ValerioCac/SE_Eyeglasses/README.md

# SE_Eyeglasses
Thesis about "Sensor-equipped Eyeglasses" for a bachelor degree in computer science.
