ValerioCac/SE_Eyeglasses/Images/AlgorithmFlowChart/AlgorithmFlowChart1.png

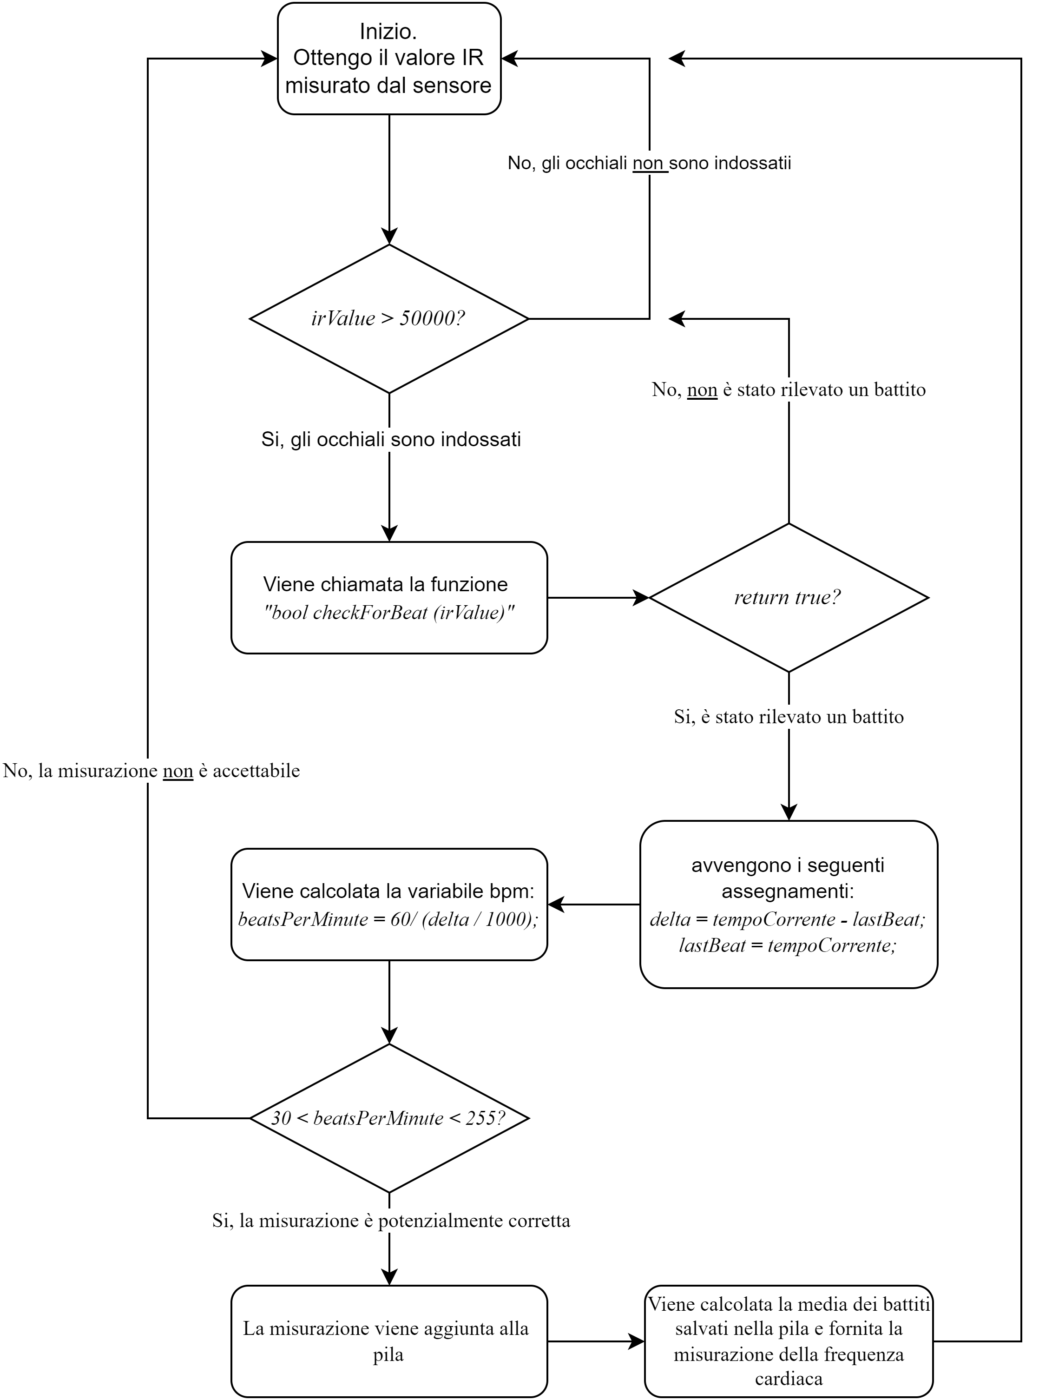
Images/AlgorithmFlowChart/AlgorithmFlowChart1.png
