ValerioCac/SE_Eyeglasses/Images/AlgorithmFlowChart/AlgorithmFlowChart2.png

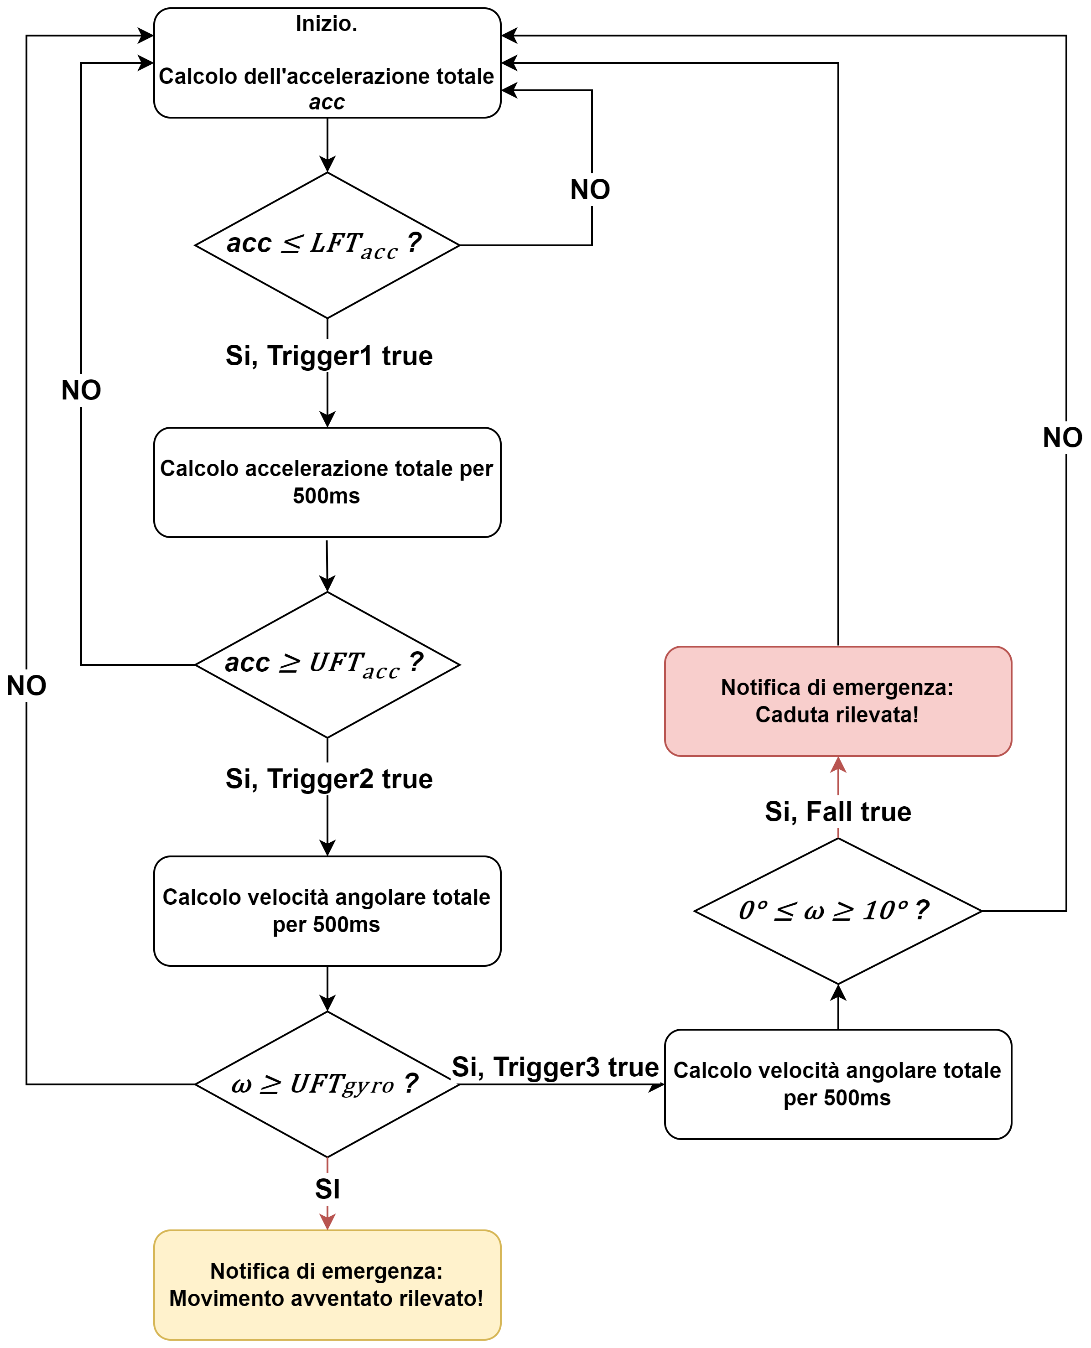
Images/AlgorithmFlowChart/AlgorithmFlowChart2.png
