ValerioCac/SE_Eyeglasses/Images/AlgorithmFlowChart/AlgorithmFlowChart3.png

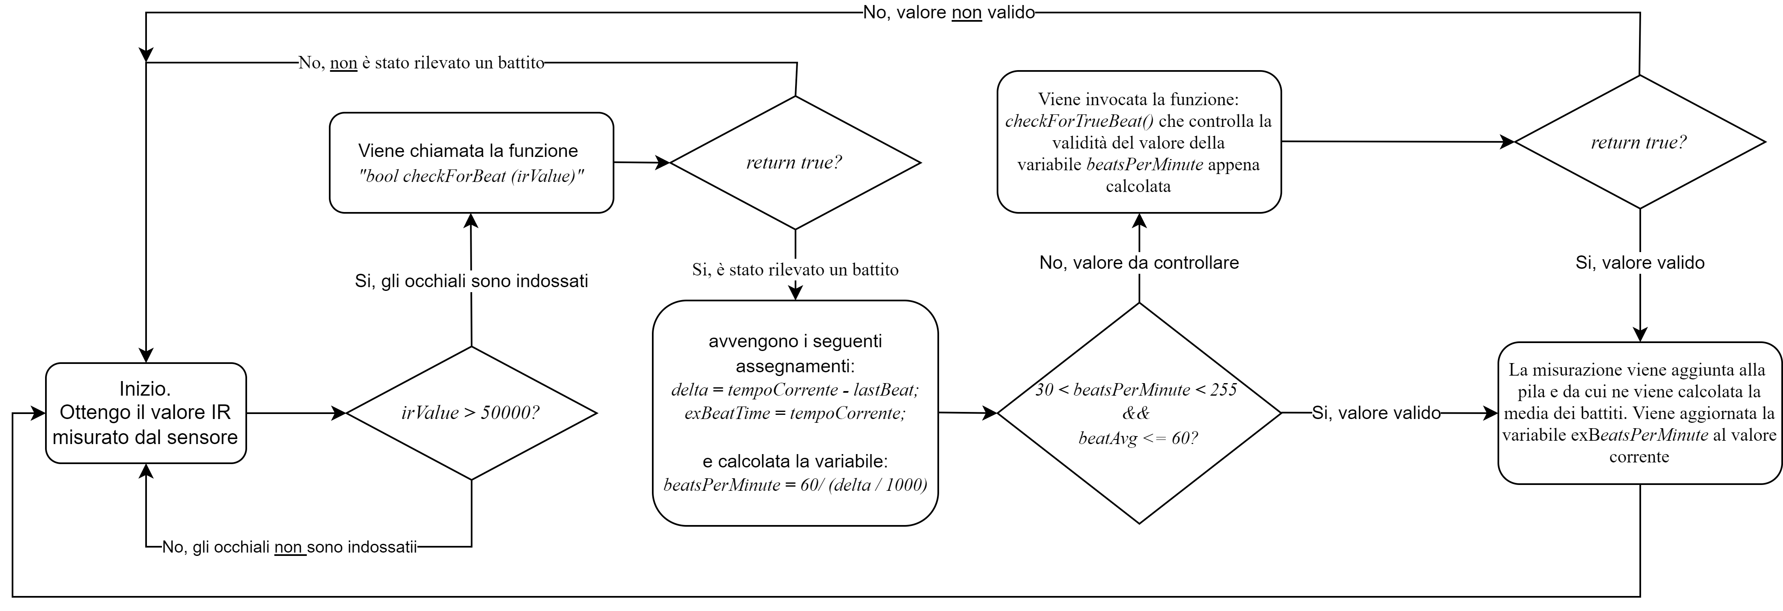
Images/AlgorithmFlowChart/AlgorithmFlowChart3.png
