ValerioCac/SE_Eyeglasses/Images/CircuitDesignDiagrams/CircuitDesign_img1.png

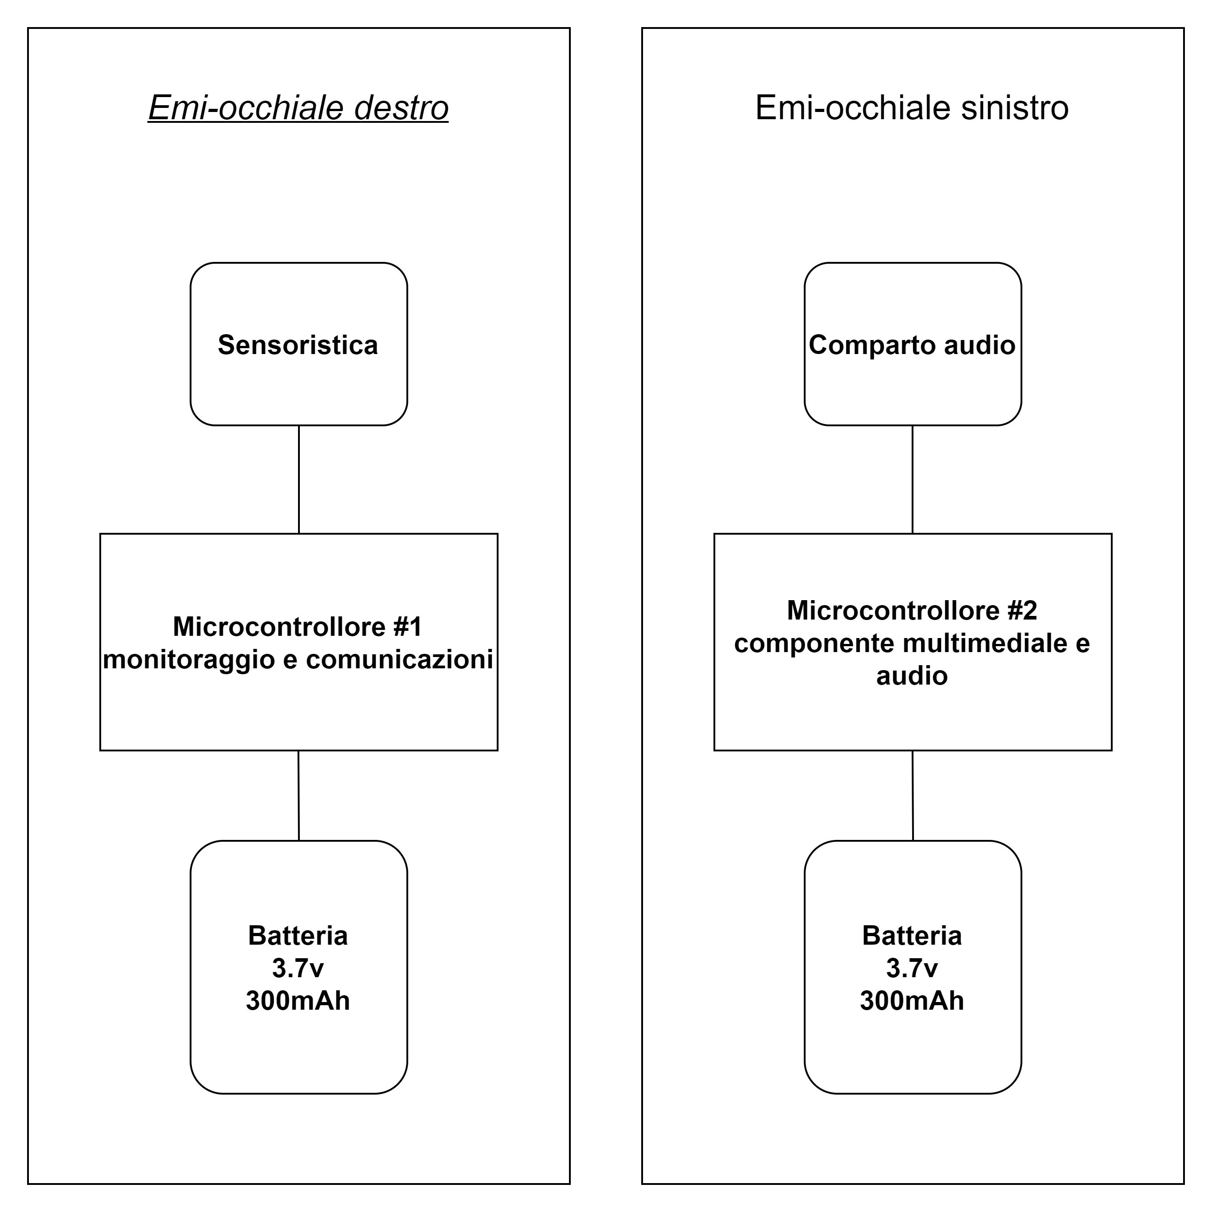
Images/CircuitDesignDiagrams/CircuitDesign_img1.png
