ValerioCac/SE_Eyeglasses/Images/CircuitDesignDiagrams/CircuitDesign_img2.png

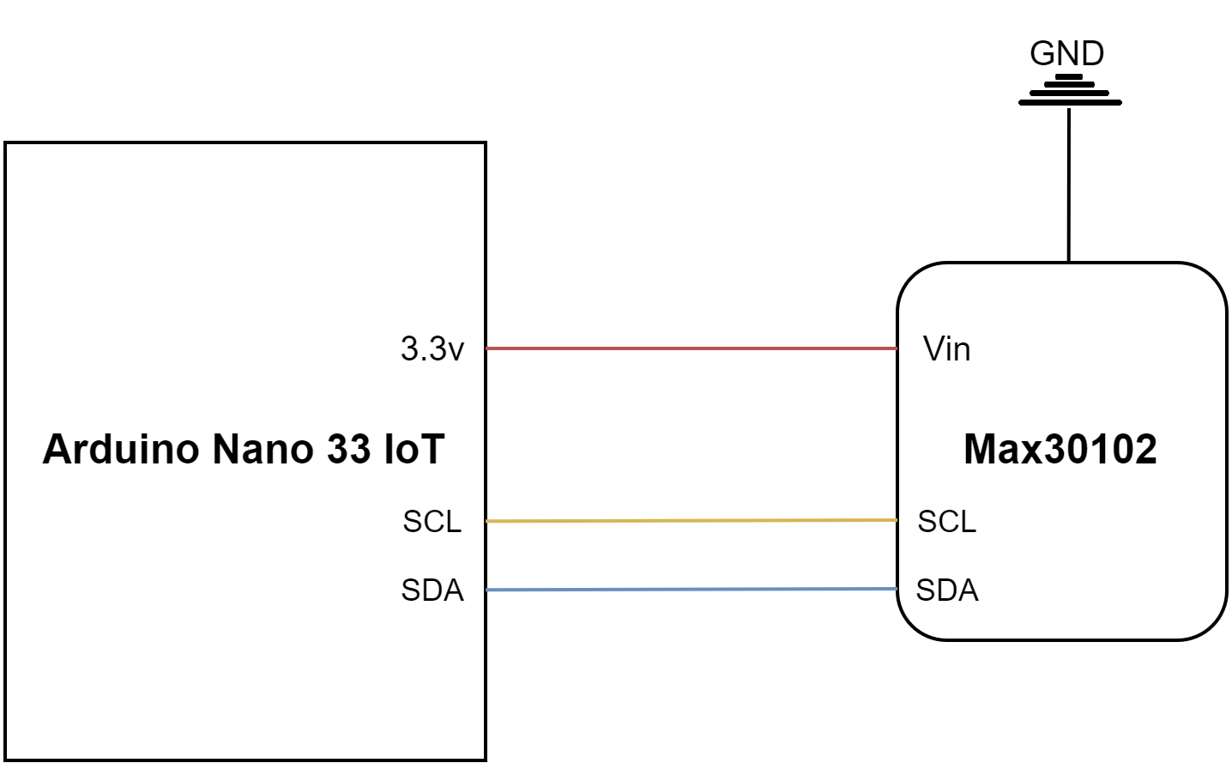
Images/CircuitDesignDiagrams/CircuitDesign_img2.png
