ValerioCac/SE_Eyeglasses/Images/CircuitDesignDiagrams/CircuitDesign_img3.png

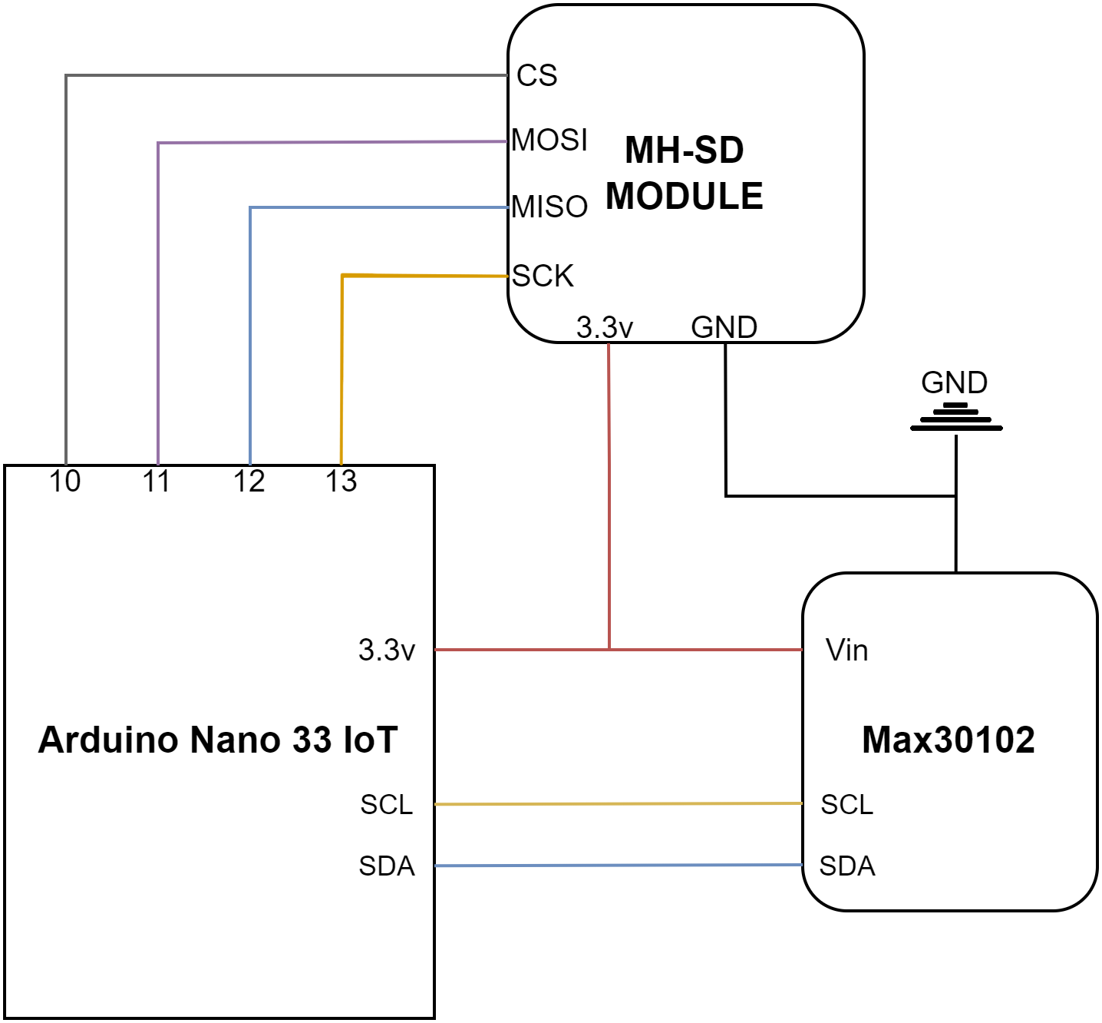
Images/CircuitDesignDiagrams/CircuitDesign_img3.png
