ValerioCac/SE_Eyeglasses/Images/Prototypes/3D Renderings/SE-Eyeglasses 2.0v v9.png

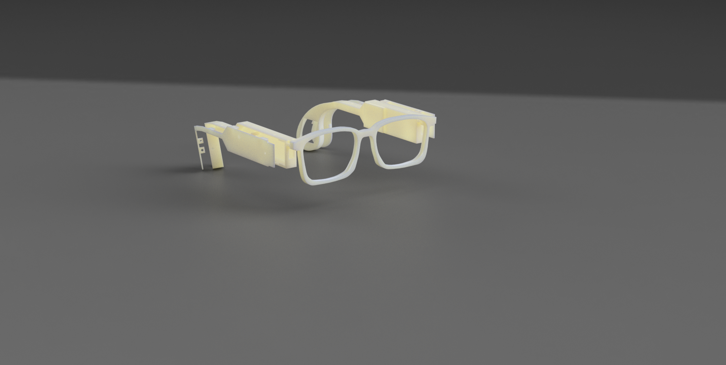
Images/Prototypes/3D Renderings/SE-Eyeglasses 2.0v v9.png
