ValerioCac/SE_Eyeglasses/Images/Prototypes/3D Renderings/SE-Eyeglasses 3.0v v51.png

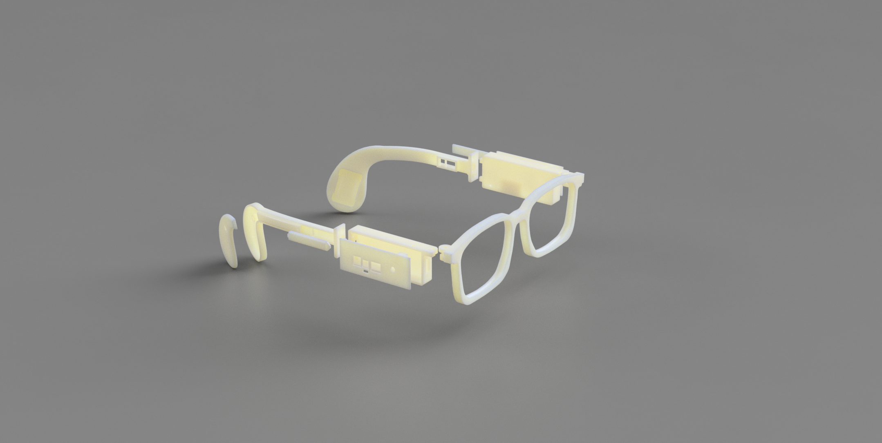
Images/Prototypes/3D Renderings/SE-Eyeglasses 3.0v v51.png
