ValerioCac/SE_Eyeglasses/Images/Prototypes/3D Renderings/SE-Eyeglasses Final v13.png

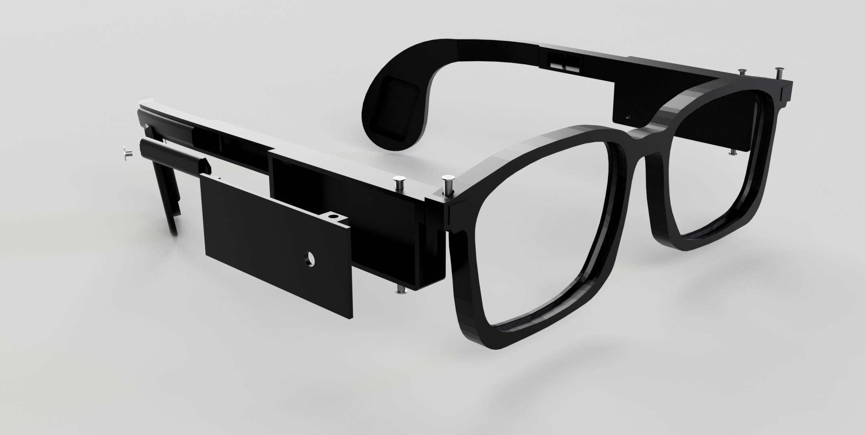
Images/Prototypes/3D Renderings/SE-Eyeglasses Final v13.png
