ValerioCac/SE_Eyeglasses/Images/Prototypes/Prototypes Sketch.png

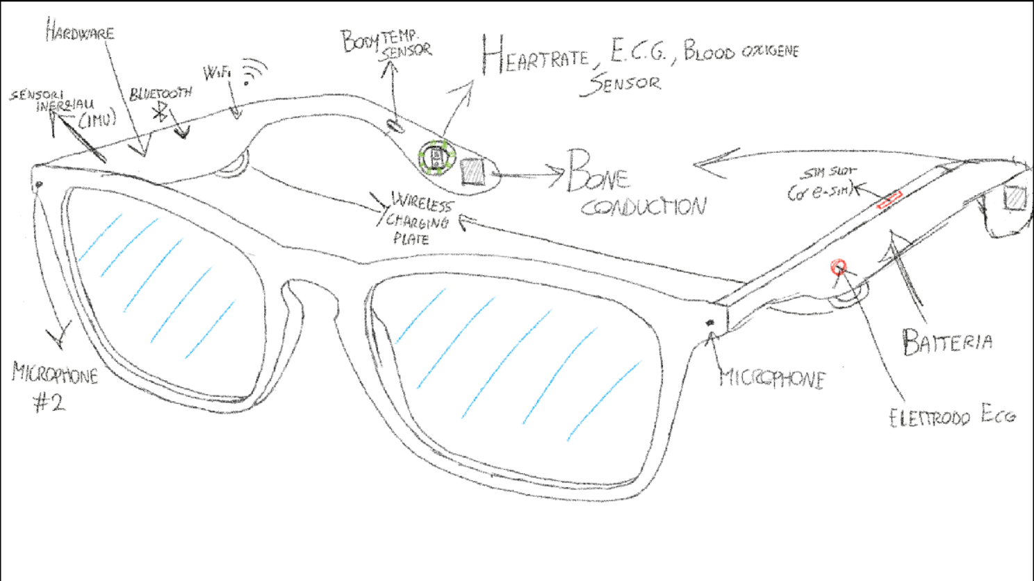
Images/Prototypes/Prototypes Sketch.png
