ValerioCac/SE_Eyeglasses/Images/Prototypes/Version 4/Asta_DX.png

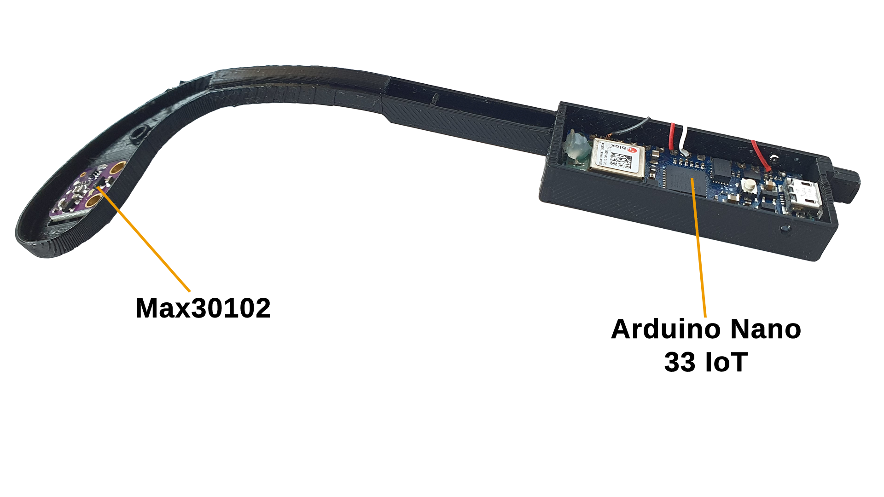
Images/Prototypes/Version 4/Asta_DX.png
