ValerioCac/SE_Eyeglasses/Images/Prototypes/Version 4/Asta_SX.png

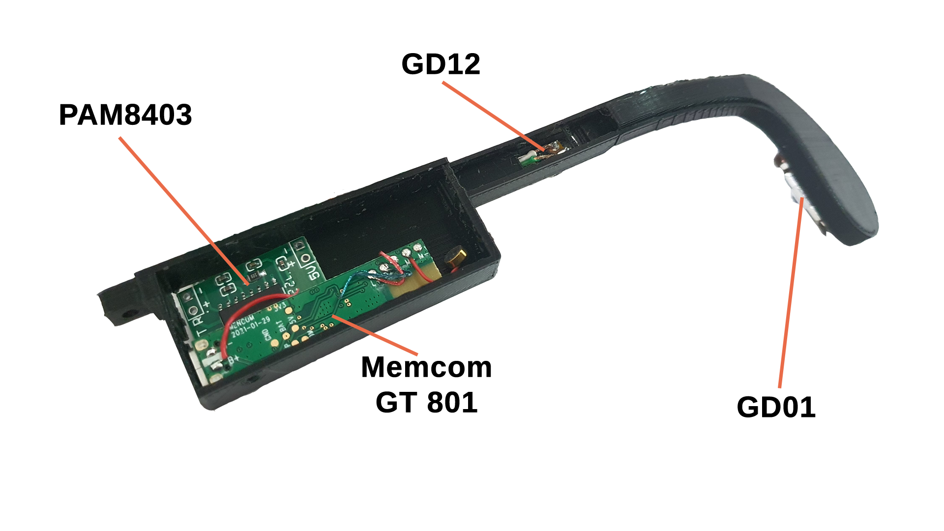
Images/Prototypes/Version 4/Asta_SX.png
