ValerioCac/SE_Eyeglasses/Images/Prototypes/Version 4/Se_Eyeglasses.png

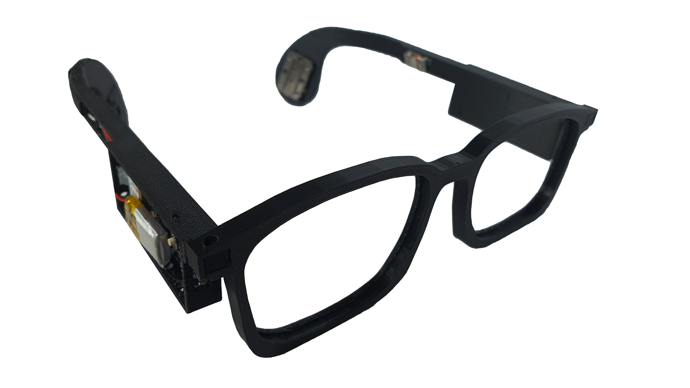
Images/Prototypes/Version 4/Se_Eyeglasses.png
