ValerioCac/SE_Eyeglasses/3D Models/Timelapse/STL/Frame.stl

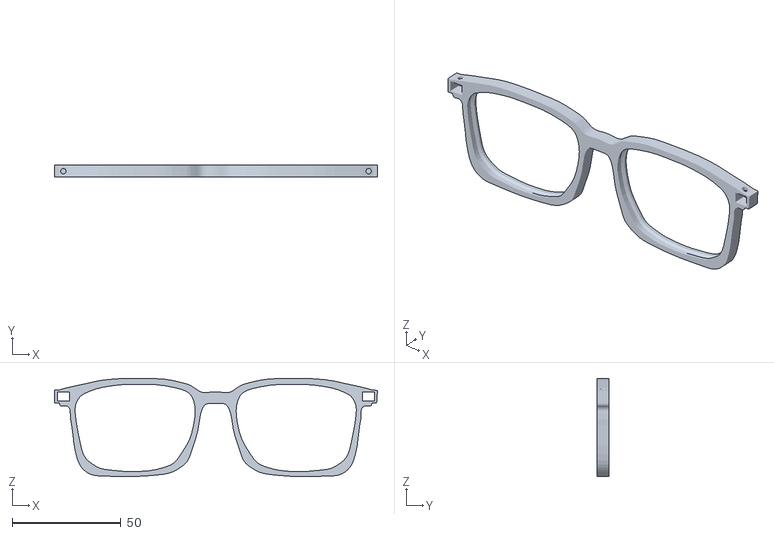
[picture p63: CAD file, 2022-03-22]
3D Models/Timelapse/STL/Frame.stl
148.6 x 5.45 x 45.2
