ValerioCac/SE_Eyeglasses/3D Models/Timelapse/STL/Asta DX.stl

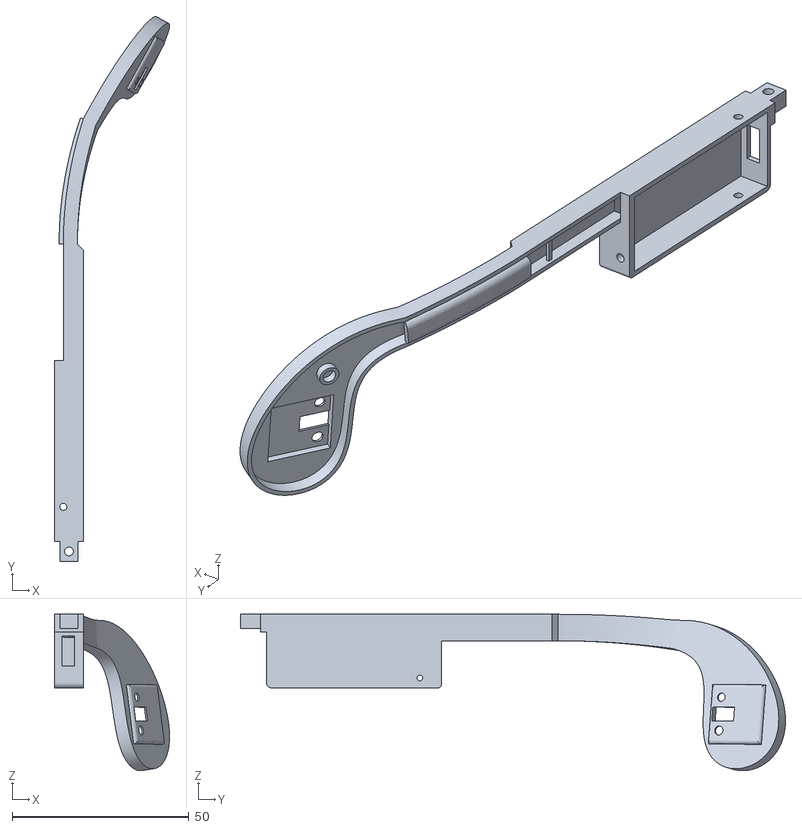
[picture p64: CAD file, 2022-03-22]
3D Models/Timelapse/STL/Asta DX.stl
32.5 x 154.0 x 44.2
