ValerioCac/SE_Eyeglasses/3D Models/Timelapse/STL/SX copCorpo.stl

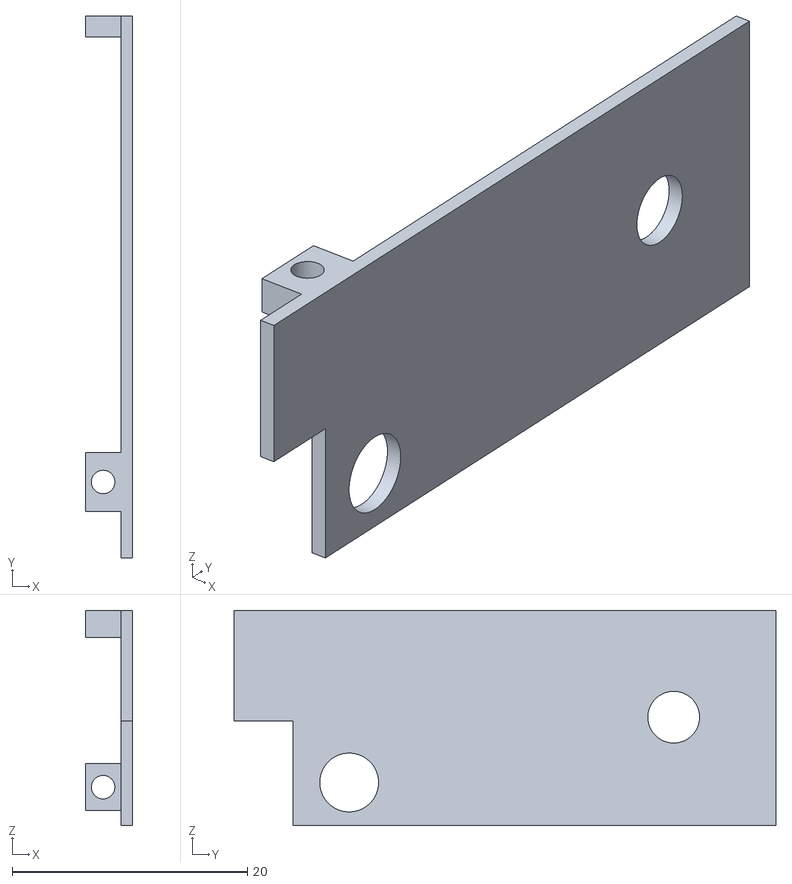
[picture p66: CAD file, 2022-03-22]
3D Models/Timelapse/STL/SX copCorpo.stl
4.00 x 46.1 x 18.3
