ValerioCac/SE_Eyeglasses/3D Models/Timelapse/STL/Asta SX.stl

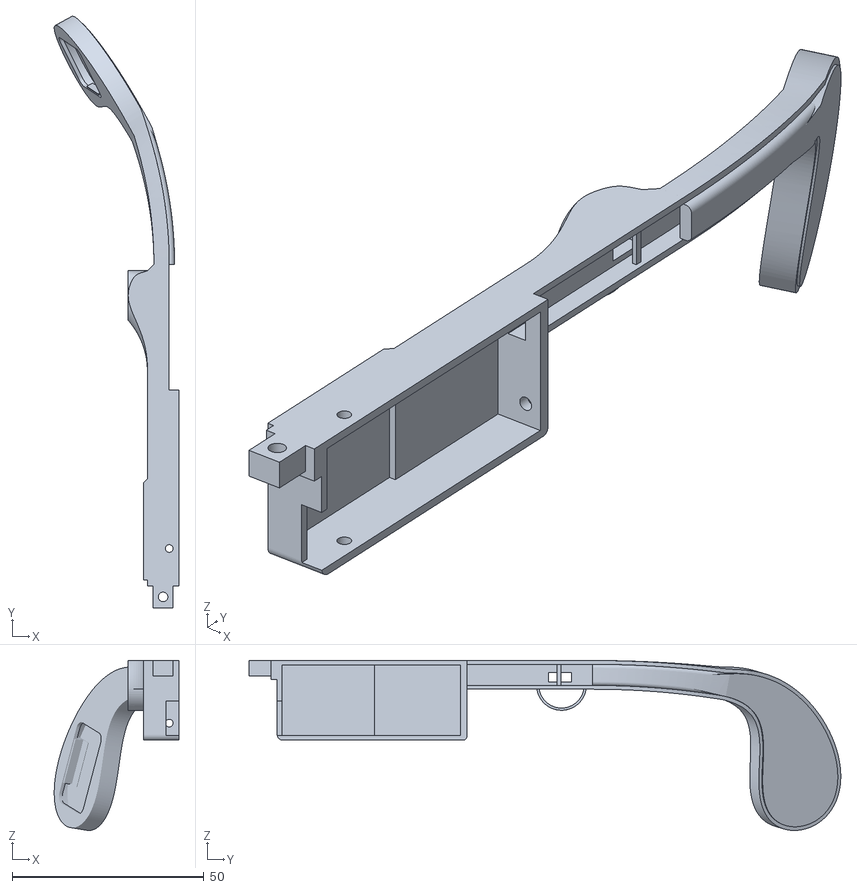
[picture p67: CAD file, 2022-03-22]
3D Models/Timelapse/STL/Asta SX.stl
32.5 x 154.4 x 44.4
