ValerioCac/SE_Eyeglasses/3D Models/Timelapse/STL/DX copStecca.stl

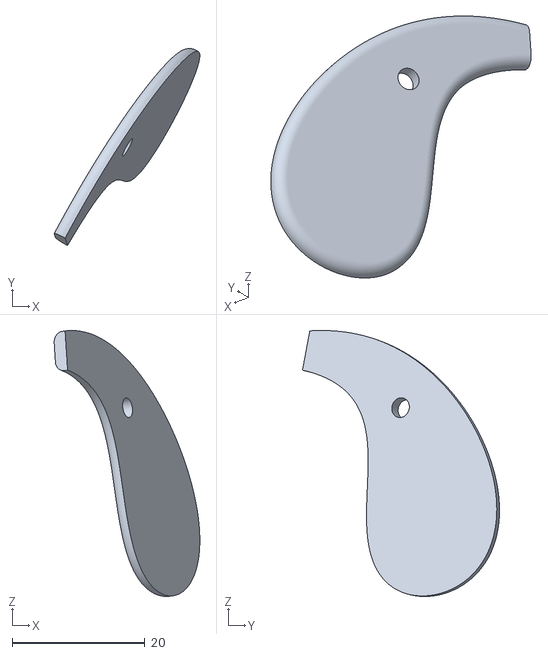
[picture p68: CAD file, 2022-03-22]
3D Models/Timelapse/STL/DX copStecca.stl
21.9 x 29.7 x 40.0
