ValerioCac/SE_Eyeglasses/TestData/FallDetectionTest/FallDetectionTest_Data.xlsx

Time(HH:MM:SS) | acc | ω | Time(HH:MM:SS) | acc | ω | Time(HH:MM:SS) | acc | ω
18:18:59 | 9 | 7 | 18:19:03 | 9 | 7 | 18:19:07 | 9 | 7
18:18:59 | 9 | 7 | 18:19:03 | 9 | 7 | 18:19:07 | 9 | 7
18:18:59 | 9 | 7 | 18:19:03 | 9 | 7 | 18:19:07 | 9 | 7
18:18:59 | 9 | 7 | 18:19:03 | 9 | 7 | 18:19:07 | 9 | 7
18:18:59 | 9 | 7 | 18:19:03 | 10 | 7 | 18:19:07 | 9 | 7
18:18:59 | 10 | 7 | 18:19:03 | 9 | 7 | 18:19:07 | 9 | 7
18:19:00 | 11 | 7 | 18:19:03 | 9 | 7 | 18:19:08 | 9 | 7
18:19:00 | 9 | 7 | 18:19:04 | 9 | 7 | 18:19:08 | 9 | 7
18:19:00 | 9 | 7 | 18:19:04 | 9 | 7 | 18:19:08 | 9 | 7
18:19:00 | 10 | 7 | 18:19:04 | 9 | 7 | 18:19:08 | 9 | 7
18:19:00 | 9 | 7 | 18:19:04 | 9 | 7 | 18:19:08 | 9 | 7
18:19:00 | 9 | 7 | 18:19:04 | 9 | 7 | 18:19:08 | 9 | 7
18:19:00 | 9 | 7 | 18:19:04 | 9 | 7 | 18:19:08 | 9 | 7
18:19:01 | 10 | 7 | 18:19:04 | 9 | 7 | 18:19:09 | 9 | 7
18:19:01 | 9 | 7 | 18:19:05 | 9 | 7 | 18:19:09 | 11 | 7
18:19:01 | 9 | 7 | 18:19:05 | 9 | 7 | 18:19:09 | 9 | 7
18:19:01 | 9 | 7 | 18:19:05 | 9 | 7 | 18:19:09 | 9 | 7
18:19:01 | 10 | 7 | 18:19:05 | 9 | 7 | 18:19:09 | 9 | 7
18:19:01 | 9 | 7 | 18:19:05 | 9 | 7 | 18:19:09 | 9 | 7
18:19:01 | 10 | 7 | 18:19:05 | 9 | 7 | 18:19:09 | 9 | 7
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
