ValerioCac/SE_Eyeglasses/TestData/HeartRateTest3 07-02-22/HeartRateTest3_Data.ods

09:41:16 | 0 | 1644223191438 | 09:39:42 | 90 | 0 |  | Column A | time occhiali
09:41:17 | 0 | 1644223192438 | 09:39:52 | 90 | 0 |  | Column B | bpm occhiali
09:41:18 | 0 | 1644223194438 | 09:39:54 | 89 | 0
09:41:19 | 0 | 1644223202438 | 09:40:02 | 90 | 0 |  | Column F | epoch gw4
09:41:20 | 0 | 1644223212438 | 09:40:12 | 92 | 0 |  | Column G | time GW4
09:41:21 | 0 | 1644223222438 | 09:40:22 | 95 | 0 |  | Column H | bpm gw4 10 sec
09:41:22 | 0 | 1644223232438 | 09:40:32 | 105 | 0 |  | Column I | bpm occhiali 10 sec
09:41:23 | 0 | 1644223242438 | 09:40:42 | 112 | 0
09:41:24 | 0 | 1644223252438 | 09:40:52 | 111 | 0
09:41:25 | 0 | 1644223262438 | 09:41:02 | 108 | 0
09:41:26 | 0 | 1644223272438 | 09:41:12 | 105 | 0
09:41:27 | 4 | 1644223282438 | 09:41:22 | 103 | 0
09:41:28 | 4 | 1644223303438 | 09:41:32 | 90 | 16
09:41:29 | 4 | 1644223304438 | 09:41:42 | 90 | 58
09:41:30 | 14 | 1644223312438 | 09:41:52 | 90 | 94
09:41:31 | 14 | 1644223322438 | 09:42:02 | 90 | 93
09:41:32 | 16 | 1644223332438 | 09:42:12 | 93 | 89
09:41:33 | 17 | 1644223342438 | 09:42:22 | 93 | 92
09:41:34 | 20 | 1644223352438 | 09:42:32 | 94 | 99
09:41:35 | 20 | 1644223362438 | 09:42:42 | 96 | 98
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
