ValerioCac/SE_Eyeglasses/TestData/HeartRateTest4 03-03-22/HeartRateTest4_Data.ods

18:26:45 | 86 | 80 | Column 1 | Column 2 | Column 3
18:26:46 | 70 | 80 | Time(HH:MM:SS) | SE Eyeglasses RAW bpm | SE Eyeglasses elaborated bpm
18:26:46 | 70 | 80
18:26:49 | 70 | 78
18:26:50 | 42 | 76
18:26:51 | 94 | 76
18:26:52 | 71 | 75
18:26:54 | 28 | 75
18:26:54 | 94 | 76
18:26:55 | 71 | 76
18:26:56 | 71 | 75
18:26:57 | 40 | 73
18:26:59 | 44 | 70
18:27:00 | 68 | 70
18:27:00 | 75 | 70
18:27:01 | 79 | 69
18:27:02 | 86 | 69
18:27:03 | 79 | 70
18:27:03 | 71 | 70
18:27:04 | 86 | 71
18:27:05 | 77 | 73
18:27:06 | 94 | 73
18:27:06 | 75 | 74
18:27:07 | 73 | 72
18:27:08 | 70 | 72
18:27:10 | 30 | 72
18:27:11 | 41 | 70
18:27:12 | 91 | 73
18:27:13 | 100 | 77
18:27:14 | 66 | 77
18:27:14 | 77 | 77
18:27:15 | 111 | 79
18:27:16 | 81 | 79
18:27:16 | 88 | 80
18:27:17 | 88 | 81
18:27:18 | 85 | 81
18:27:18 | 88 | 81
18:27:19 | 77 | 80
18:27:20 | 77 | 80
18:27:20 | 88 | 81
18:27:21 | 107 | 84
18:27:22 | 107 | 88
18:27:23 | 107 | 89
18:27:25 | 107 | 90
18:27:25 | 97 | 92
18:27:26 | 97 | 93
18:27:26 | 97 | 92
18:27:27 | 100 | 94
18:27:28 | 100 | 94
18:27:29 | 100 | 95
18:27:30 | 100 | 96
18:27:30 | 97 | 97
18:27:31 | 88 | 97
18:27:33 | 88 | 98
18:27:33 | 88 | 98
18:27:34 | 88 | 97
18:27:35 | 88 | 96
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
