ValerioCac/SE_Eyeglasses/TestData/HeartRateTest5 04-03-22/HeartRateTest5_Data.ods

23:44:14 | 4 | 0 | Column 1 | Column 2 | Column 3
23:44:15 | 64 | 4 | Time(HH:MM:SS) | SE Eyeglasses RAW bpm | SE Eyeglasses elaborated bpm
23:44:16 | 79 | 9
23:44:19 | 22 | 9
23:44:19 | 91 | 15
23:44:20 | 73 | 20
23:44:21 | 68 | 25
23:44:22 | 71 | 29
23:44:23 | 68 | 34
23:44:23 | 91 | 40
23:44:24 | 75 | 45
23:44:25 | 85 | 51
23:44:26 | 97 | 57
23:44:26 | 70 | 62
23:44:27 | 61 | 66
23:44:28 | 71 | 70
23:44:29 | 77 | 76
23:44:30 | 81 | 77
23:44:31 | 68 | 76
23:44:31 | 83 | 75
23:44:32 | 86 | 76
23:44:33 | 68 | 76
23:44:34 | 83 | 77
23:44:35 | 66 | 77
23:44:36 | 36 | 77
23:44:37 | 77 | 76
23:44:38 | 79 | 76
23:44:38 | 94 | 77
23:44:39 | 94 | 77
23:44:40 | 79 | 77
23:44:41 | 73 | 78
23:44:44 | 19 | 78
23:44:44 | 136 | 78
23:44:45 | 81 | 79
23:44:46 | 79 | 79
23:44:46 | 94 | 80
23:44:47 | 71 | 80
23:44:48 | 73 | 80
23:44:49 | 75 | 80
23:44:50 | 70 | 79
23:44:50 | 66 | 78
23:44:51 | 73 | 78
23:44:52 | 60 | 77
23:44:53 | 70 | 77
23:44:54 | 83 | 78
23:44:56 | 25 | 78
23:44:57 | 77 | 77
23:44:58 | 43 | 77
23:44:59 | 65 | 75
23:45:00 | 86 | 75
23:45:01 | 77 | 74
23:45:02 | 77 | 74
23:45:02 | 73 | 74
23:45:03 | 71 | 74
23:45:04 | 83 | 74
23:45:05 | 79 | 73
23:45:05 | 77 | 73
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
