ValerioCac/SE_Eyeglasses/Images/Prototypes/3D Renderings/SE-Eyeglasses experimental 3.0v v7.png

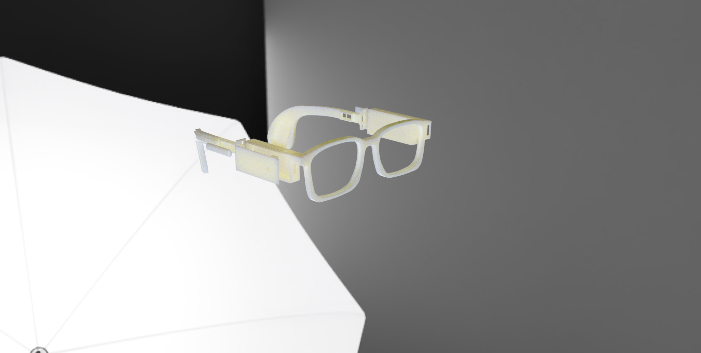
Images/Prototypes/3D Renderings/SE-Eyeglasses experimental 3.0v v7.png
