ValerioCac/SE_Eyeglasses/TestData/FallDetectionTest/FallDetectionTest_img4.png

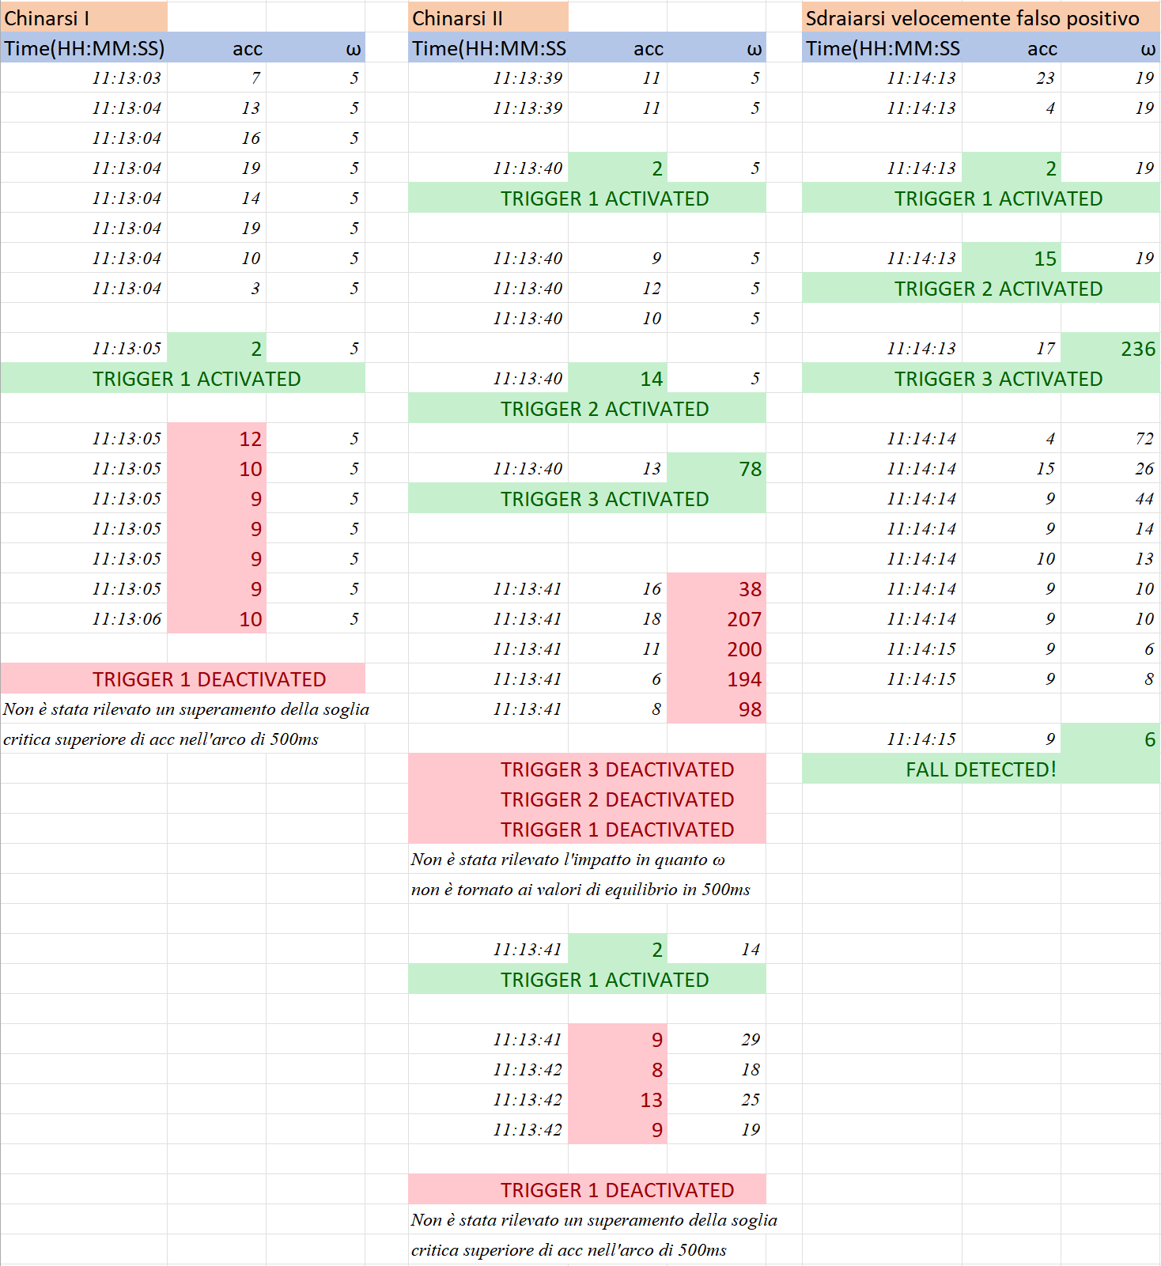
TestData/FallDetectionTest/FallDetectionTest_img4.png
