ValerioCac/SE_Eyeglasses/TestData/FallDetectionTest/FallDetectionTest_img5.png

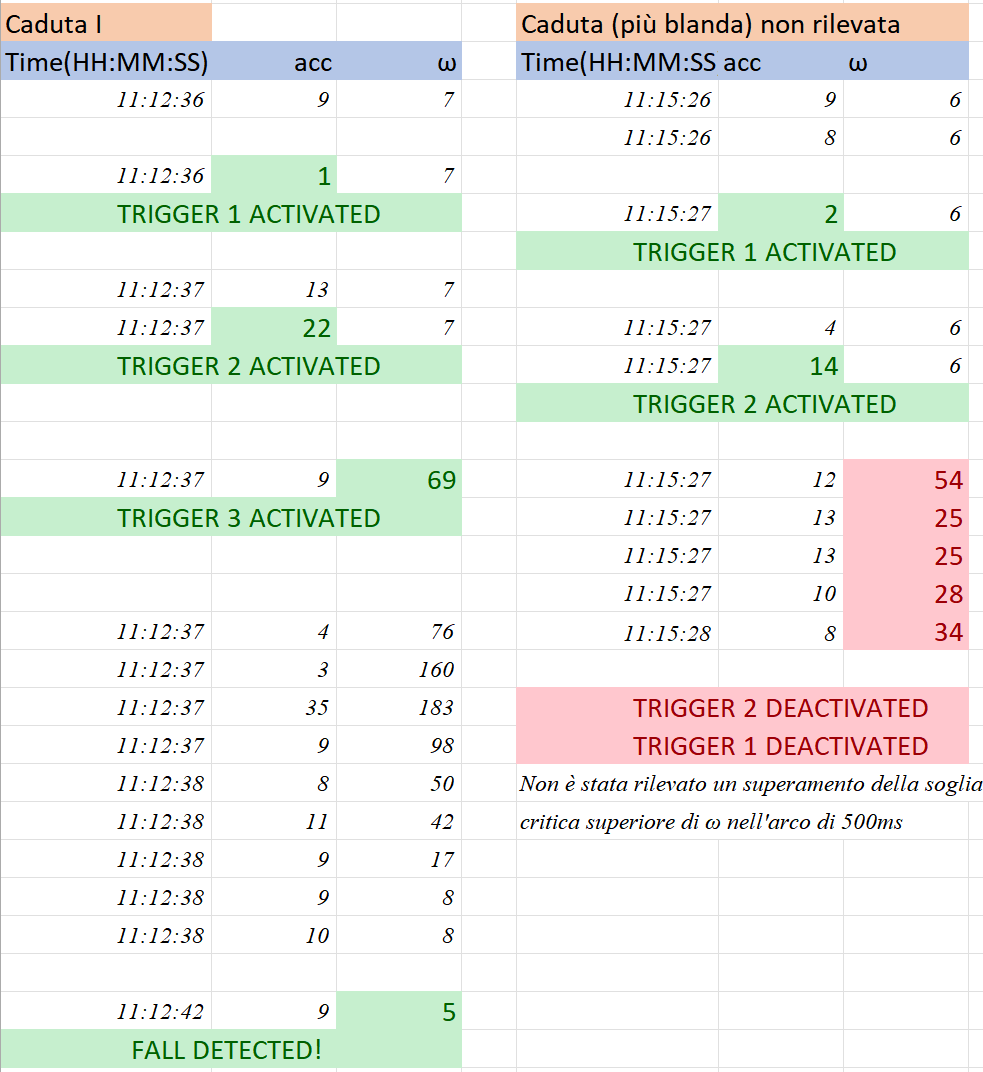
TestData/FallDetectionTest/FallDetectionTest_img5.png
