ValerioCac/SE_Eyeglasses/TestData/HeartRateTest1 02-02-22/HeartRateTest1_Chart.png

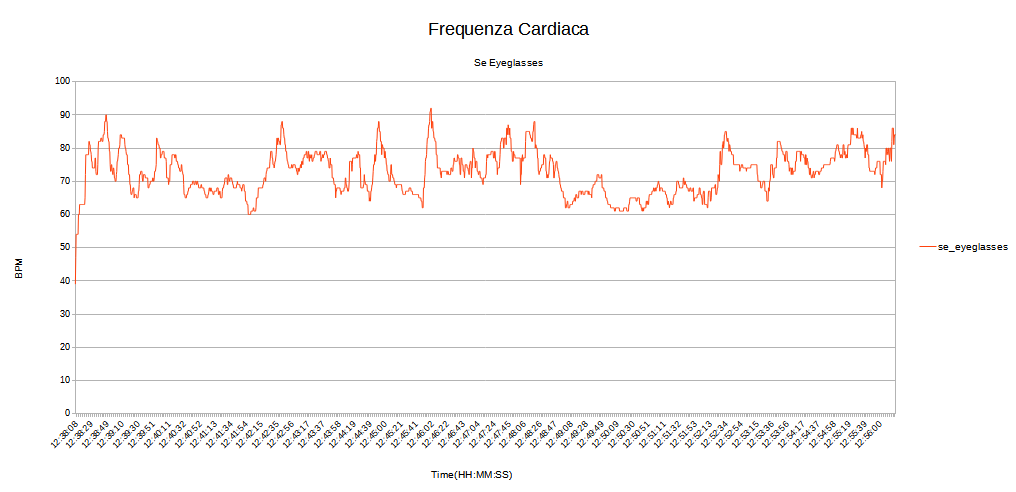
TestData/HeartRateTest1 02-02-22/HeartRateTest1_Chart.png
