ValerioCac/SE_Eyeglasses/TestData/HeartRateTest2 05-02-22/HeartRateTest2_Chart1.png

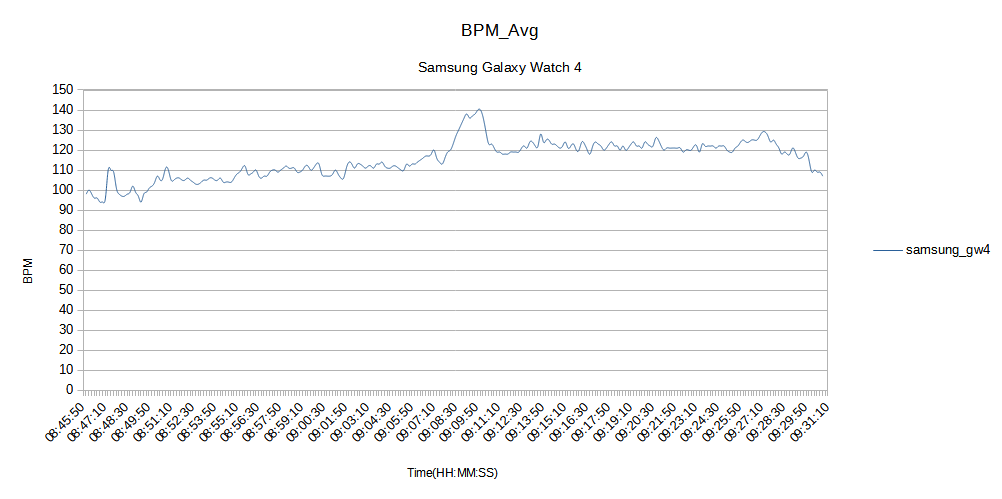
TestData/HeartRateTest2 05-02-22/HeartRateTest2_Chart1.png
