ValerioCac/SE_Eyeglasses/TestData/HeartRateTest4 03-03-22/HeartRateTest4_Chart.png

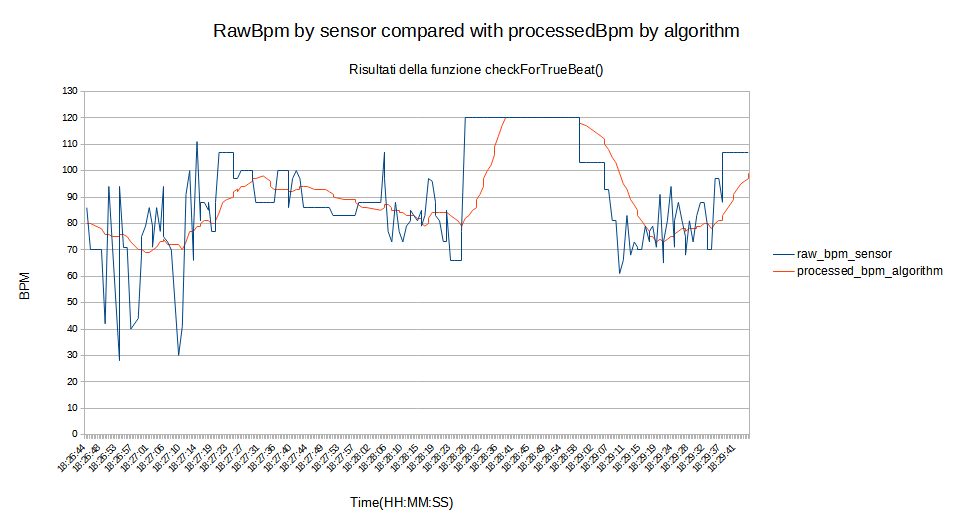
TestData/HeartRateTest4 03-03-22/HeartRateTest4_Chart.png
